be1ieve/esp32cam_v7rc_car/media/concept_car.jpg

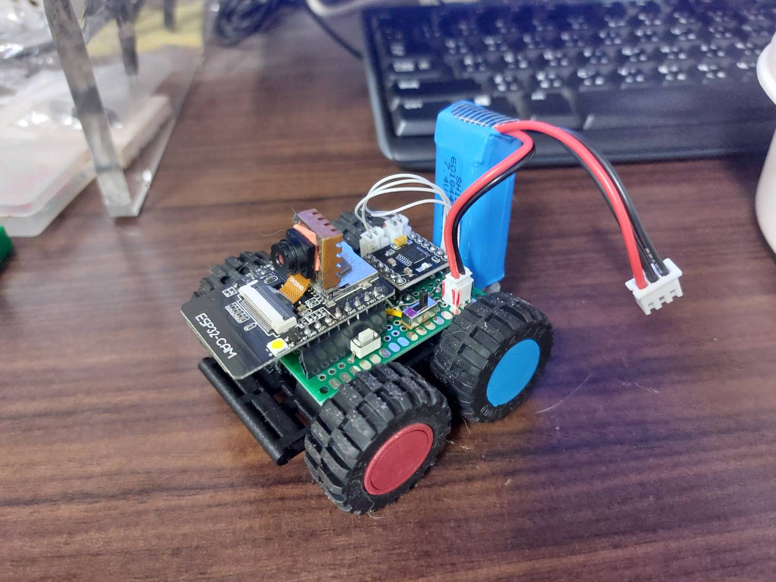
media/concept_car.jpg
