be1ieve/esp32cam_v7rc_car/media/concept_design.jpg

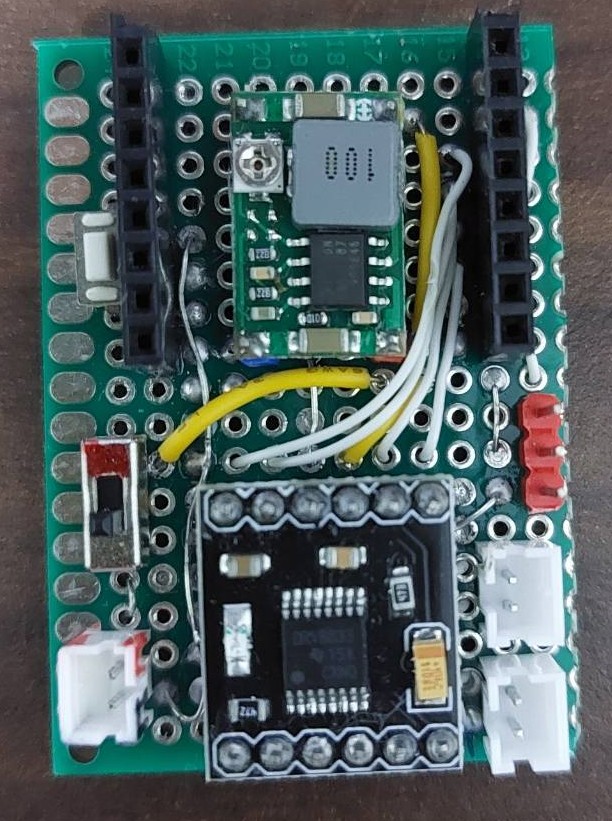
media/concept_design.jpg
