be1ieve/esp32cam_v7rc_car/media/lego_front.jpg

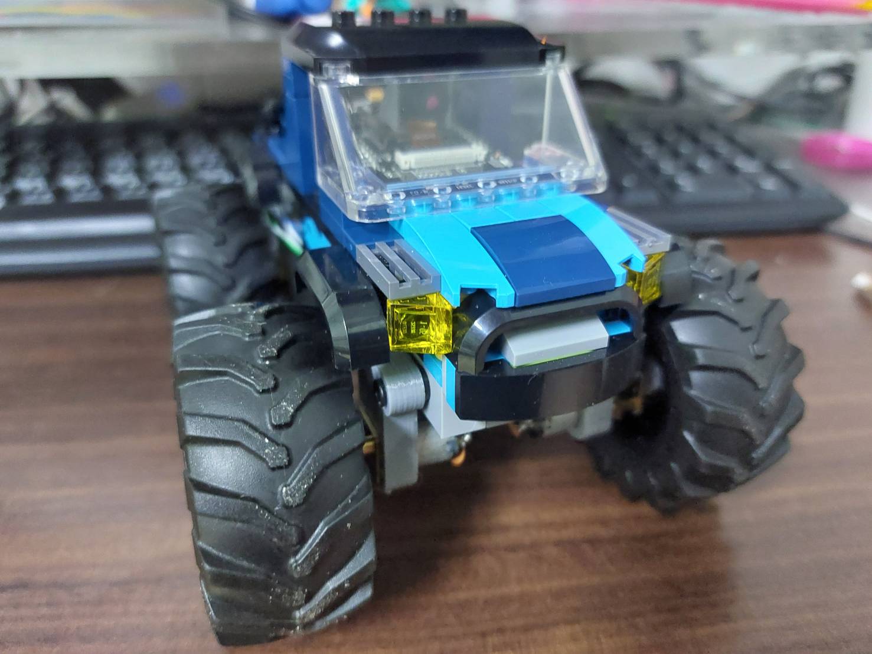
media/lego_front.jpg
