be1ieve/esp32cam_v7rc_car/src/camera.h

#ifndef _CAMERA_H_
#define _CAMERA_H_

#include <Arduino.h>
#include "esp_camera.h"
#include "esp_http_server.h"

/* 
 * Below are camera settings for ESP32-Cam module 
 */
#define PWDN_GPIO_NUM  32
#define RESET_GPIO_NUM -1
#define XCLK_GPIO_NUM  0
#define SIOD_GPIO_NUM  26
#define SIOC_GPIO_NUM  27
#define Y9_GPIO_NUM    35
#define Y8_GPIO_NUM    34
#define Y7_GPIO_NUM    39
#define Y6_GPIO_NUM    36
#define Y5_GPIO_NUM    21
#define Y4_GPIO_NUM    19
#define Y3_GPIO_NUM    18
#define Y2_GPIO_NUM    5
#define VSYNC_GPIO_NUM 25
#define HREF_GPIO_NUM  23
#define PCLK_GPIO_NUM  22
#define LED_GPIO_NUM   4 // 4 for flash led or 33 for normal led

/*
 * Below are stream settings for packet assambly
 */
#define PART_BOUNDARY "1234567890AZ"
static const char* _STREAM_CONTENT_TYPE = "multipart/x-mixed-replace;boundary=" PART_BOUNDARY;
static const char* _STREAM_BOUNDARY = "\r\n--" PART_BOUNDARY "\r\n";
static const char* _STREAM_HEADER = "Content-Type: image/jpeg\r\nContent-Length: %u\r\nX-Timestamp: %d.%06d\r\n\r\n";

httpd_handle_t stream_httpd = NULL;

void cameraInit(){
  // camera config copied from ESP32-CAM example
  camera_config_t config;
  config.ledc_channel = LEDC_CHANNEL_0;
  config.ledc_timer = LEDC_TIMER_0;
  config.pin_d0 = Y2_GPIO_NUM;
  config.pin_d1 = Y3_GPIO_NUM;
  config.pin_d2 = Y4_GPIO_NUM;
  config.pin_d3 = Y5_GPIO_NUM;
  config.pin_d4 = Y6_GPIO_NUM;
  config.pin_d5 = Y7_GPIO_NUM;
  config.pin_d6 = Y8_GPIO_NUM;
  config.pin_d7 = Y9_GPIO_NUM;
  config.pin_xclk = XCLK_GPIO_NUM;
  config.pin_pclk = PCLK_GPIO_NUM;
  config.pin_vsync = VSYNC_GPIO_NUM;
  config.pin_href = HREF_GPIO_NUM;
  config.pin_sccb_sda = SIOD_GPIO_NUM;
  config.pin_sccb_scl = SIOC_GPIO_NUM;
  config.pin_pwdn = PWDN_GPIO_NUM;
  config.pin_reset = RESET_GPIO_NUM;
  config.xclk_freq_hz = 20000000;
  //config.frame_size = FRAMESIZE_VGA; // 640*480
  config.frame_size = FRAMESIZE_QVGA; // 320*240
  //config.frame_size = FRAMESIZE_QQVGA; // 160*120 (might crash)
  config.pixel_format = PIXFORMAT_JPEG;  // for streaming
  config.grab_mode = CAMERA_GRAB_WHEN_EMPTY;
  config.fb_location = CAMERA_FB_IN_DRAM;
  config.jpeg_quality = 10;
  config.fb_count = 2;

  esp_err_t err = esp_camera_init(&config);
  if (err != ESP_OK) {
    Serial.printf("Camera init failed with error 0x%x", err);
    delay(3000);
    //reset and try again, or maybe put it to deep sleep
    ESP.restart();
    delay(5000);
  }
}

static esp_err_t stream_handler(httpd_req_t *req){
  camera_fb_t * fb = NULL;
  struct timeval _timestamp;
  esp_err_t res = ESP_OK;
  size_t _jpg_buf_len = 0;
  uint8_t * _jpg_buf = NULL;
  char * part_buf[64];

  // first set packet type to multipart stream
  res = httpd_resp_set_type(req, _STREAM_CONTENT_TYPE);
  if(res != ESP_OK) return res;

  while(true){ // keep sending frames
    fb = esp_camera_fb_get(); //grep a frame from camera
    if (!fb) {
      Serial.println("Camera capture failed");
      res = ESP_FAIL;
    }
    else {
      _timestamp.tv_sec = fb->timestamp.tv_sec;
      _timestamp.tv_usec = fb->timestamp.tv_usec;
      _jpg_buf_len = fb->len;
      _jpg_buf = fb->buf;
    }

    /*
     * For each frame send to client:
     *   First send an frame header to declare image data type and size.
     *   Second send whole image data.
     *   Last send a frame separator.
     */
    if(res == ESP_OK){ // First part
      size_t hlen = snprintf((char *)part_buf, 128, _STREAM_HEADER, _jpg_buf_len, _timestamp.tv_sec, _timestamp.tv_usec);
      res = httpd_resp_send_chunk(req, (const char *)part_buf, hlen);
    }
    if(res == ESP_OK){ // Second part
      res = httpd_resp_send_chunk(req, (const char *)_jpg_buf, _jpg_buf_len);
    }
    if(res == ESP_OK){ // Last part
      res = httpd_resp_send_chunk(req, _STREAM_BOUNDARY, strlen(_STREAM_BOUNDARY));
    }

    if(fb){ // release camera framebuffer
      esp_camera_fb_return(fb);
      fb = NULL;
      _jpg_buf = NULL;
    }
    if(_jpg_buf){ // release jpeg image buffer
      free(_jpg_buf);
      _jpg_buf = NULL;
    }

    /*
     * Error code 45062: camera stream disconnected. timeout or normal exit
     * When grabing image using aduino library, you will always find this error flooding.
    */
    if(res != ESP_OK){
      Serial.printf("Error code: %d\n", res);
      break;
    }
  } // end of one frame

  return res;

}

void startCameraServer(){
  httpd_config_t config = HTTPD_DEFAULT_CONFIG();
  config.server_port = 81;
  httpd_uri_t stream_uri = {
    .uri       = "/stream",
    .method    = HTTP_GET,
    .handler   = stream_handler,
    .user_ctx  = NULL
  };

  if (httpd_start(&stream_httpd, &config) == ESP_OK) {
    httpd_register_uri_handler(stream_httpd, &stream_uri);
  }
  else{
    Serial.println("Stream server failed.");
  }
}


#endif
