be1ieve/esp32cam_v7rc_car/(commit log)

2024-09-30 change motor behavior
    modify motor pwm handling to avoid sudden ramp up
    [esp32cam-v7rc-car.ino]
2024-10-19 add LED support
    add two led channel on GPIO 4 and 16
2024-10-24 Update esp32cam-v7rc-car.ino
    update gpio pins to reflect v2 pcb design
2024-10-24 add pcb design
2024-10-25 Add wiring guide
2024-10-30 Add motor non-pwm control
